iWaheeb/Astrolabe-m10-mini/docs/notes/compass.md

# Compass - Support Components & Critical Notes

## Why IST8310?

## Role & interface

## Power supply & decoupling

## Mandatory Set/Reset capacitor

## I2C address

## Control pins

## Power-cycle / POR timing

## I2C pull-ups

## Assembly / ESD
