iWaheeb/Astrolabe-m10-mini/docs/notes/power.md

# Power Architecture & Budget

## Rail

## Input protection

## Current budget

## Sequencing

## Ramp

## Backup rail
