iWaheeb/Astrolabe-m10-mini/(commit log)

2026-08-05 update CLAUDE.md to clarify project goals; introduce a comprehension debt register to track understanding of design decisions.
2026-10-15 docs(gnss): fix GND pin count - nine, not ten. closes #4
